Yossi/car-menora/board_schematics/wires.jpg

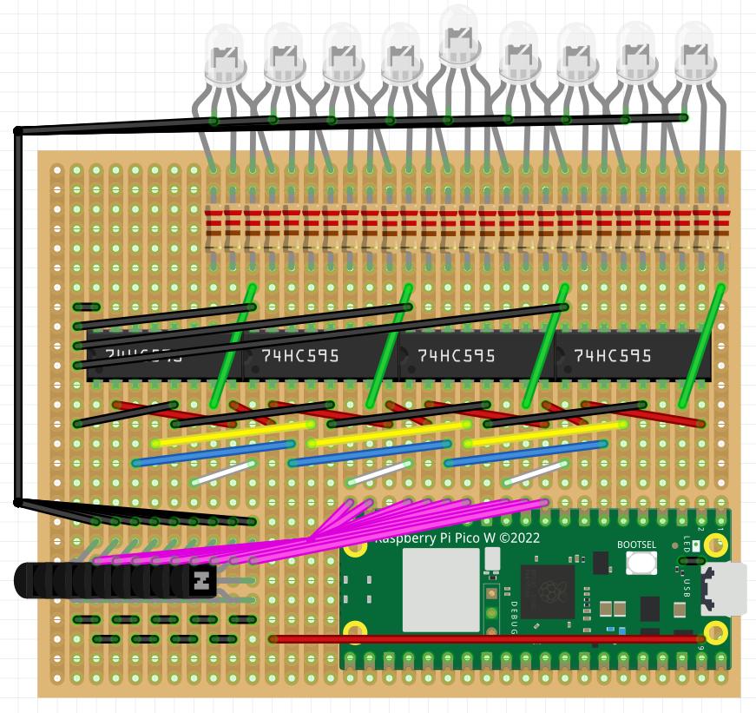
board_schematics/wires.jpg
