Yossi/car-menora/board_schematics/board.jpg

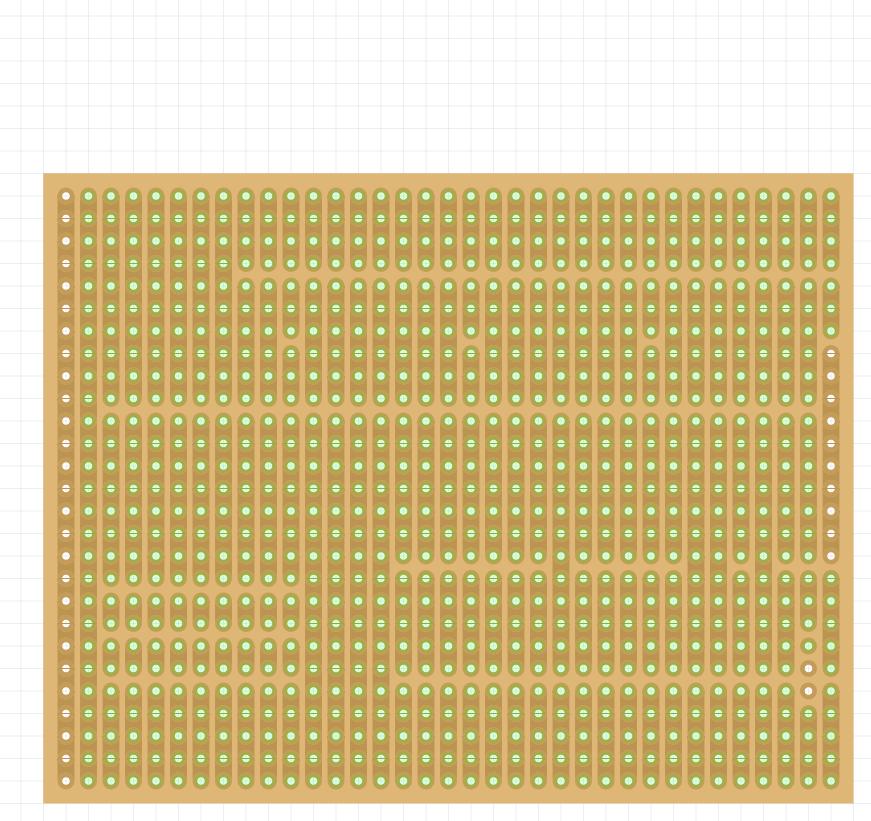
board_schematics/board.jpg
