Yossi/car-menora/board_schematics/parts.jpg

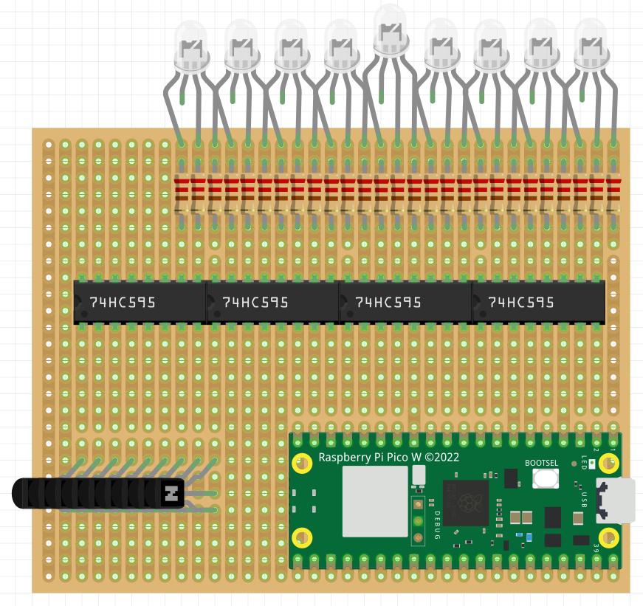
board_schematics/parts.jpg
