Yossi/car-menora/3dmodels/candlebottom.stl

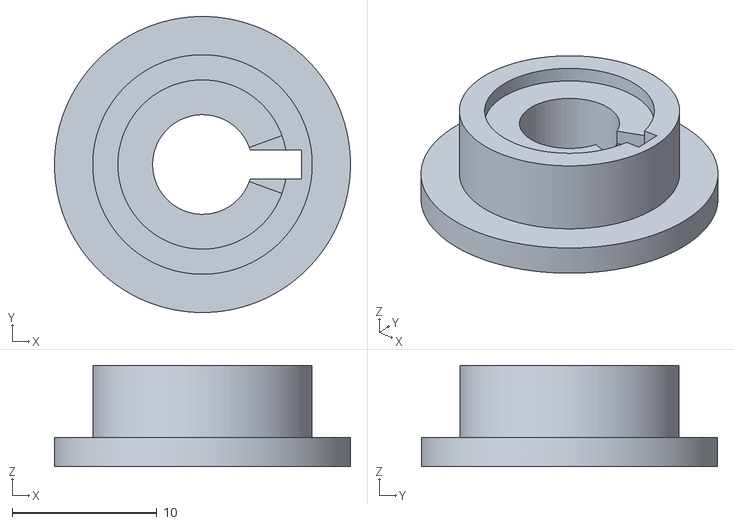
[picture p4: CAD file, 2020-11-19]
3dmodels/candlebottom.stl
20.4 x 20.4 x 7.00
