Yossi/car-menora/3dmodels/candletopper.stl

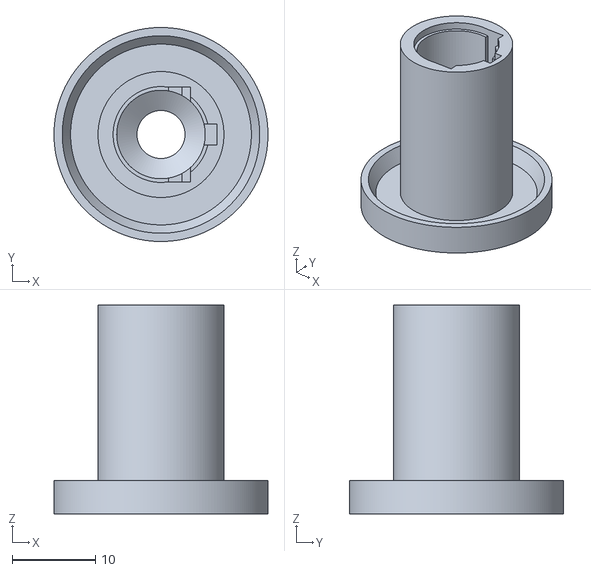
[picture p5: CAD file, 2020-11-16]
3dmodels/candletopper.stl
25.7 x 25.7 x 25.1
