Yossi/car-menora/(list of files, drawings)

Other design files:
board_schematics/menoraboard.fzz
