Yossi/car-menora/(commit log)

2020-10-29 Add .scad file and the .stl it exports as
    [candletopper.scad, candletopper.stl]
2020-10-30 removed ring that maybe was causing prints to fail
    [candletopper.scad, candletopper.stl]
2020-11-02 Ring is back. Shortened height overall
    [candletopper.scad, candletopper.stl]
2020-11-04 Thin the tube wall to make less plastic wrap around the board slot
    Also make a beveled edge to the trough to handle variations in PVC pipe thickness
    [candletopper.scad, candletopper.stl]
2020-11-05 Add some slop around the board size to try to account for PLA swelling
    [candletopper.scad, candletopper.stl]
2020-11-16 Adjust for new PVC pipe inner dimensions
    * Shrink cap
    * Create clearance for solder blobs
    * Add seat for battery contact washer
    * Add passthrough for wires to same
    [candletopper.scad, candletopper.stl]
2020-11-19 Change to a more easily importable setup
    [candletopper.scad]
2020-11-19 Add bottom cap
    [candlebottom.scad]
2020-11-19 Forgot to add candlebottom.stl
    [candlebottom.stl]
2023-10-16 Move 3dmodels to own folder
    [candlebottom.scad, candlebottom.stl, candletopper.scad, candletopper.stl]
2023-10-16 Add python code that runs on pi pico w
2023-10-16 Add schematics
    Still needs all kinds of clean up, but there is enough here to replicate my hardware
    [menoraboard.fzz]
2023-12-03 For unknown reasons this works where the other order doesn't
    [RGBsetup.py]
2024-12-30 Modify board for USB-C breakout board (power only)
    [menoraboard.fzz]
2024-12-30 Fix stack effect so it ends with right number of lights displayed
    [menorah.py]
